triagram/awr2944p-dca1000-case/step/assembly.step

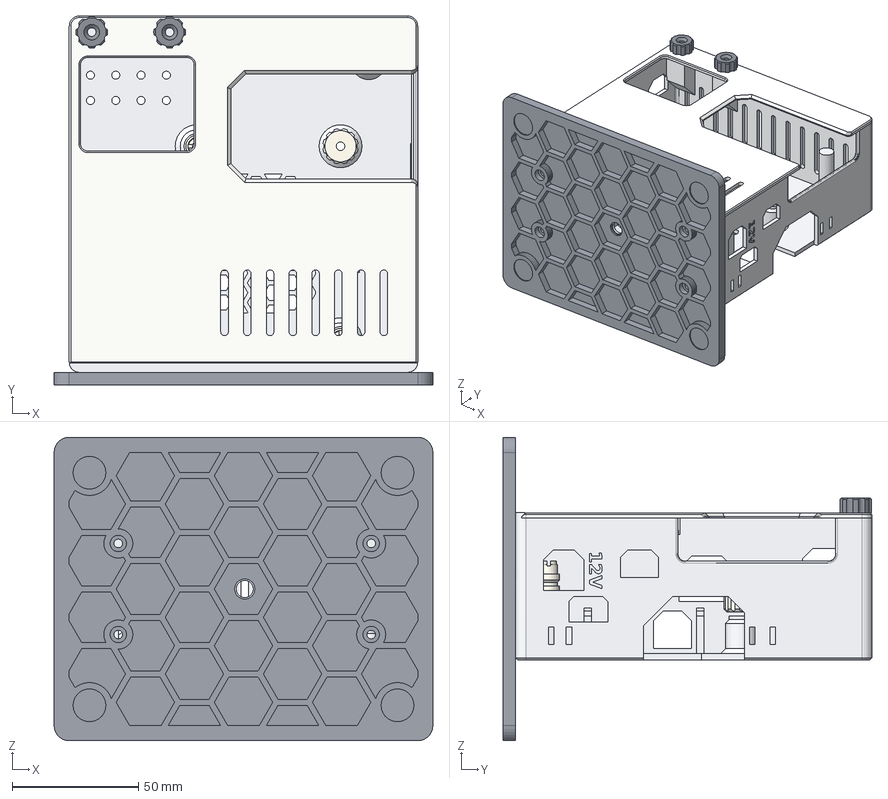
[picture p13: CAD file, 2026-11-10]
step/assembly.step
149.8 x 145.9 x 120.0 mm
case_body
front_guard
desk_foot
knob_1 x 2
spacer_1 x 3
thumb_nut
