triagram/awr2944p-dca1000-case/stl/body_pause_at_13.60mm_47.00mm_49.60mm.stl

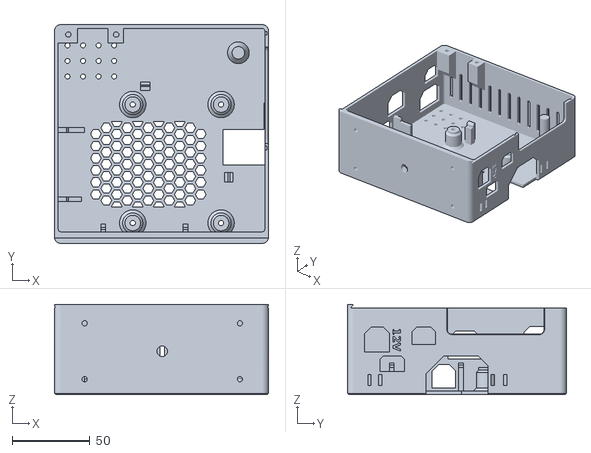
[picture p14: CAD file, 2026-11-10]
stl/body_pause_at_13.60mm_47.00mm_49.60mm.stl
137.8 x 140.9 x 58.2
