triagram/awr2944p-dca1000-case/stl/test_fit/awr2944pevm_dummy_front.stl

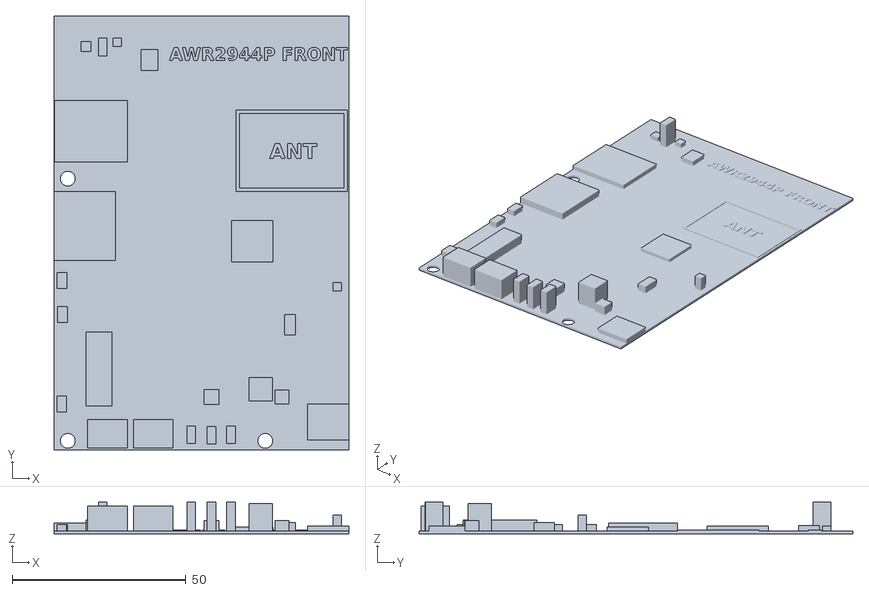
[picture p15: CAD file, 2026-11-01]
stl/test_fit/awr2944pevm_dummy_front.stl
85.0 x 125.0 x 9.18
