triagram/awr2944p-dca1000-case/stl/spacer_x3_pause_at_3.40mm_15.00mm.stl

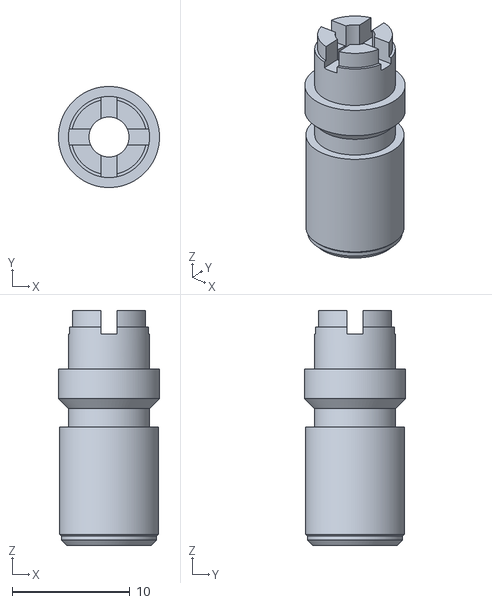
[picture p16: CAD file, 2026-11-10]
stl/spacer_x3_pause_at_3.40mm_15.00mm.stl
8.60 x 8.60 x 20.0
