triagram/awr2944p-dca1000-case/stl/test_fit/awr2944pevm_dummy_back.stl

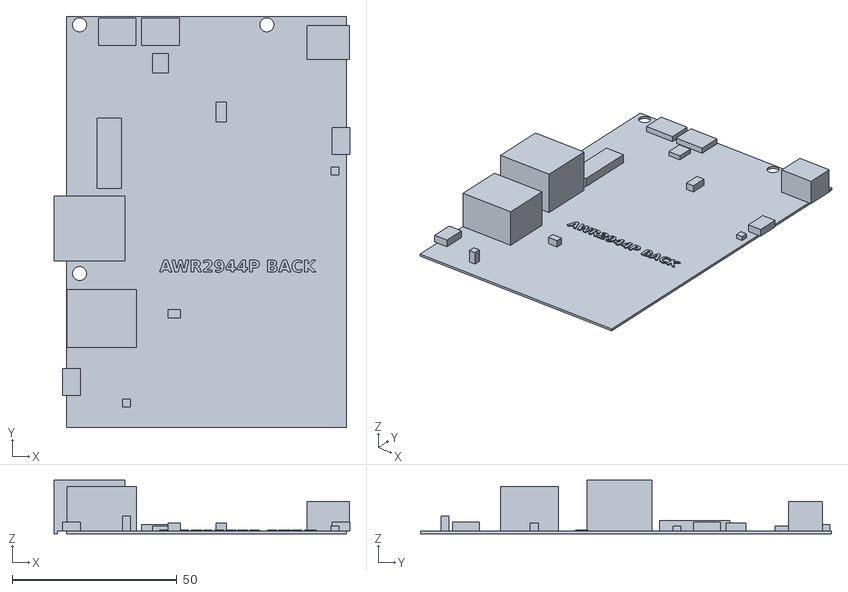
[picture p17: CAD file, 2026-11-01]
stl/test_fit/awr2944pevm_dummy_back.stl
89.9 x 125.0 x 16.3
