triagram/awr2944p-dca1000-case/stl/test_fit/dca1000_dummy_back.stl

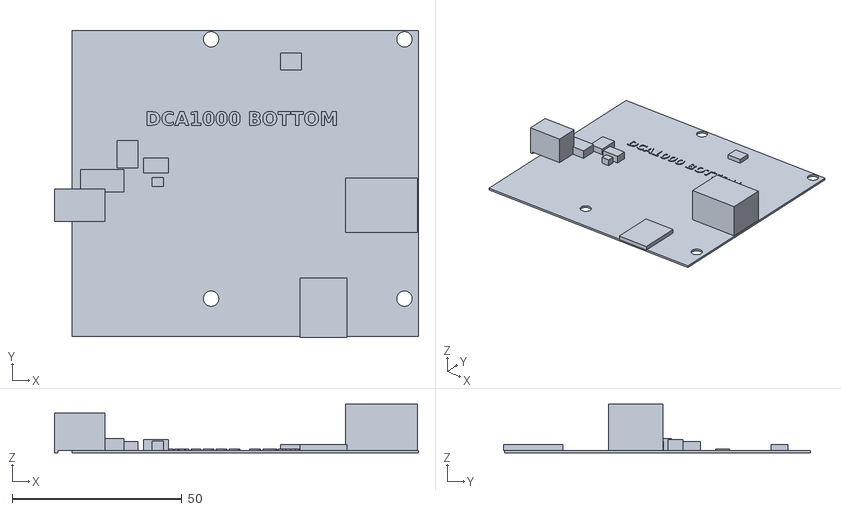
[picture p18: CAD file, 2026-11-01]
stl/test_fit/dca1000_dummy_back.stl
107.1 x 90.4 x 14.4
