triagram/awr2944p-dca1000-case/stl/knob_x2.stl

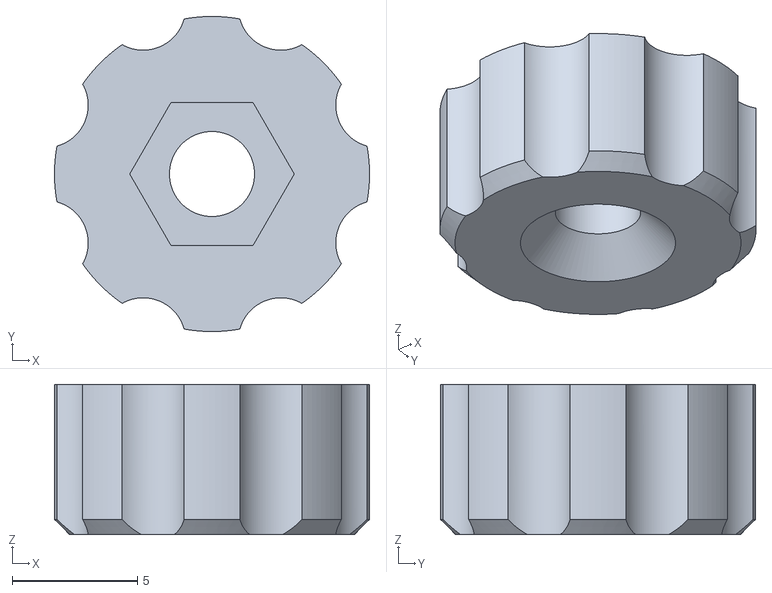
[picture p19: CAD file, 2026-11-01]
stl/knob_x2.stl
12.6 x 12.6 x 6.00
