triagram/awr2944p-dca1000-case/stl/test_fit/dca1000_dummy_front.stl

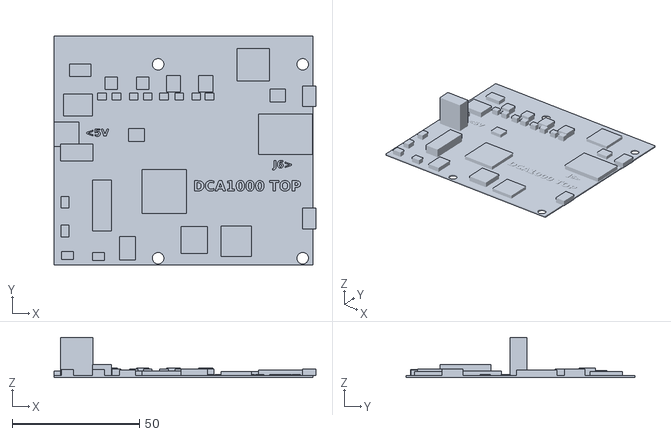
[picture p20: CAD file, 2026-11-01]
stl/test_fit/dca1000_dummy_front.stl
103.1 x 90.0 x 15.9
