triagram/awr2944p-dca1000-case/step/front_guard.step

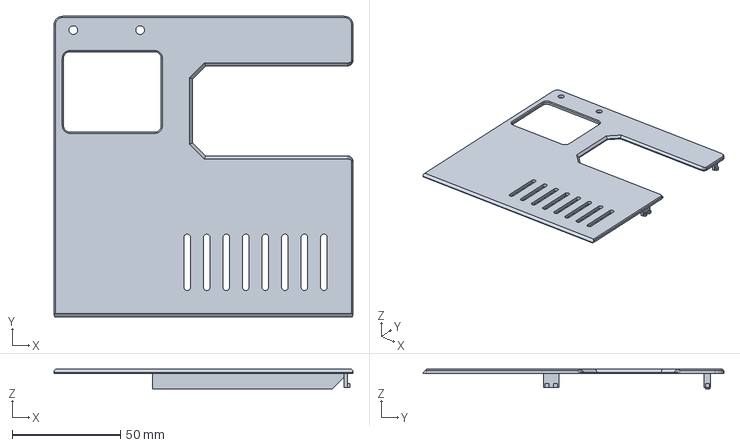
[picture p21: CAD file, 2026-11-01]
step/front_guard.step
137.8 x 138.5 x 9.00 mm
