triagram/awr2944p-dca1000-case/step/desk_foot.step

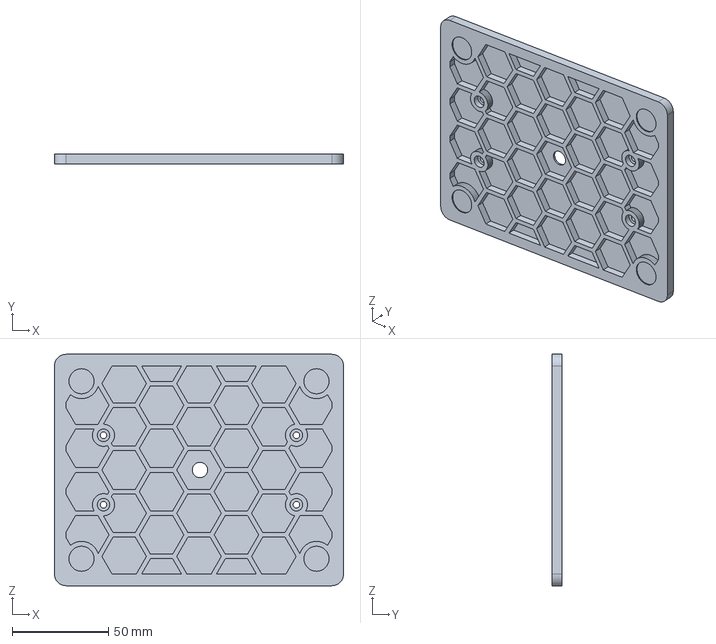
[picture p22: CAD file, 2026-11-01]
step/desk_foot.step
149.8 x 5.00 x 120.0 mm
