triagram/awr2944p-dca1000-case/step/thumb_nut.step

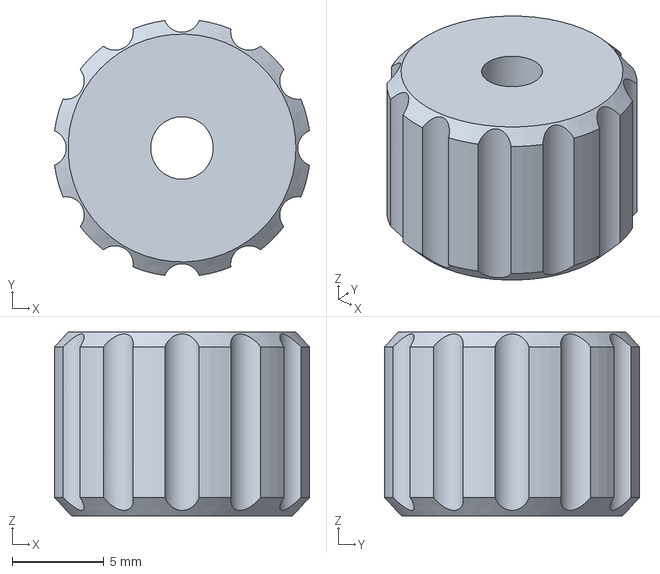
[picture p23: CAD file, 2026-11-10]
step/thumb_nut.step
13.9 x 13.9 x 10.0 mm
