triagram/awr2944p-dca1000-case/(list of files, cad)

Other CAD files:
step/spacer.step
step/body.step
step/knob.step
stl/thumb_nut_pause_at_3.40mm.stl
stl/desk_foot.stl
stl/front_guard.stl
