triagram/awr2944p-dca1000-case/images/print_pauses.zh-CN.png

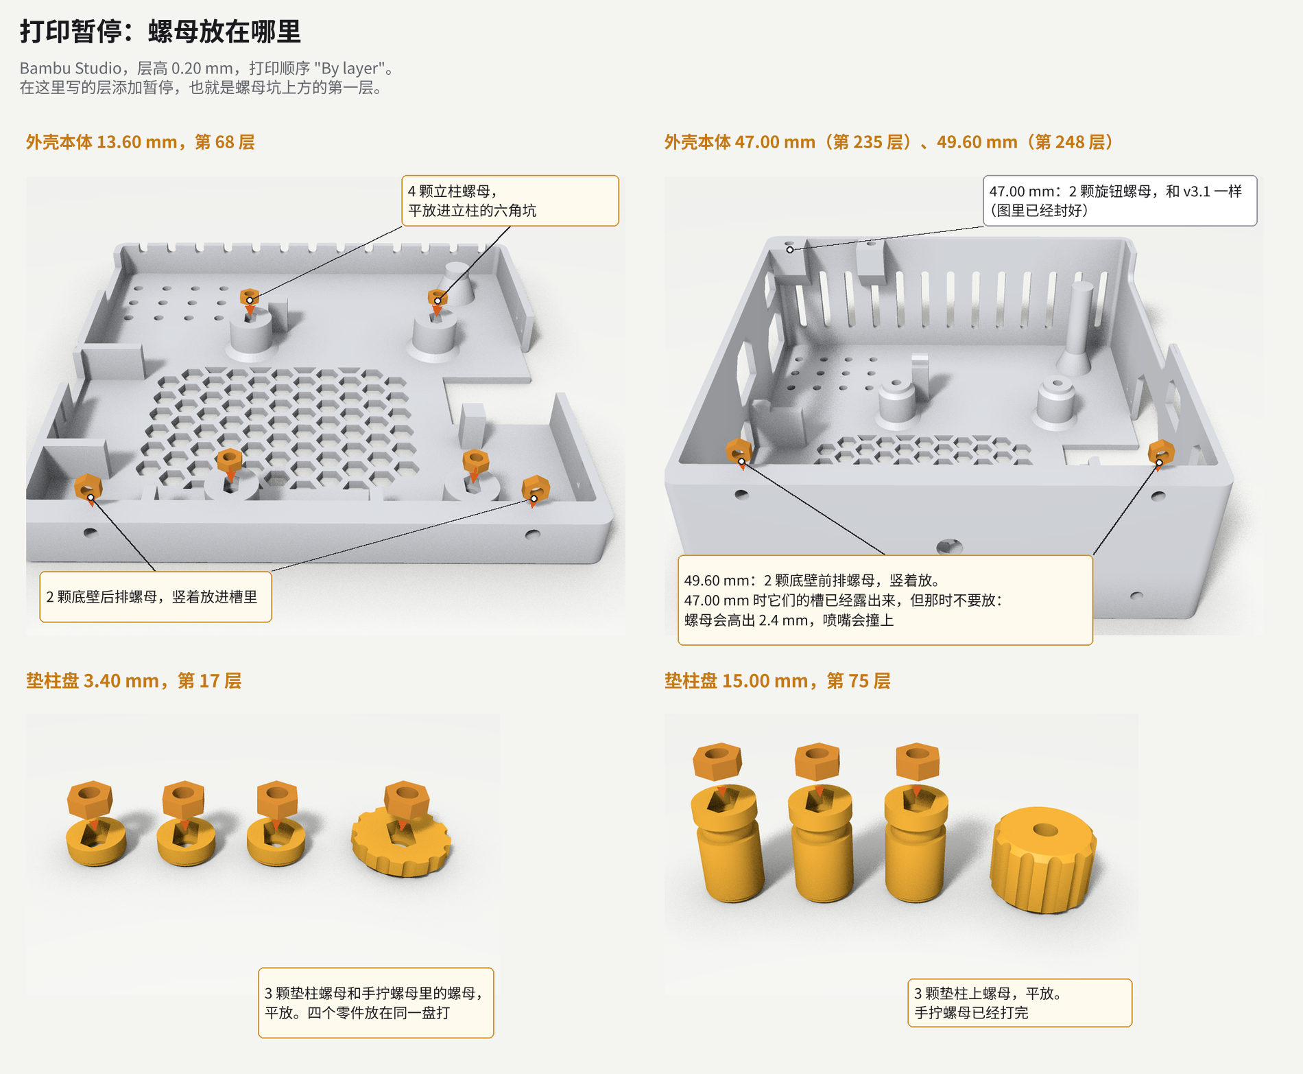
images/print_pauses.zh-CN.png
