triagram/awr2944p-dca1000-case/images/step0.zh-CN.png

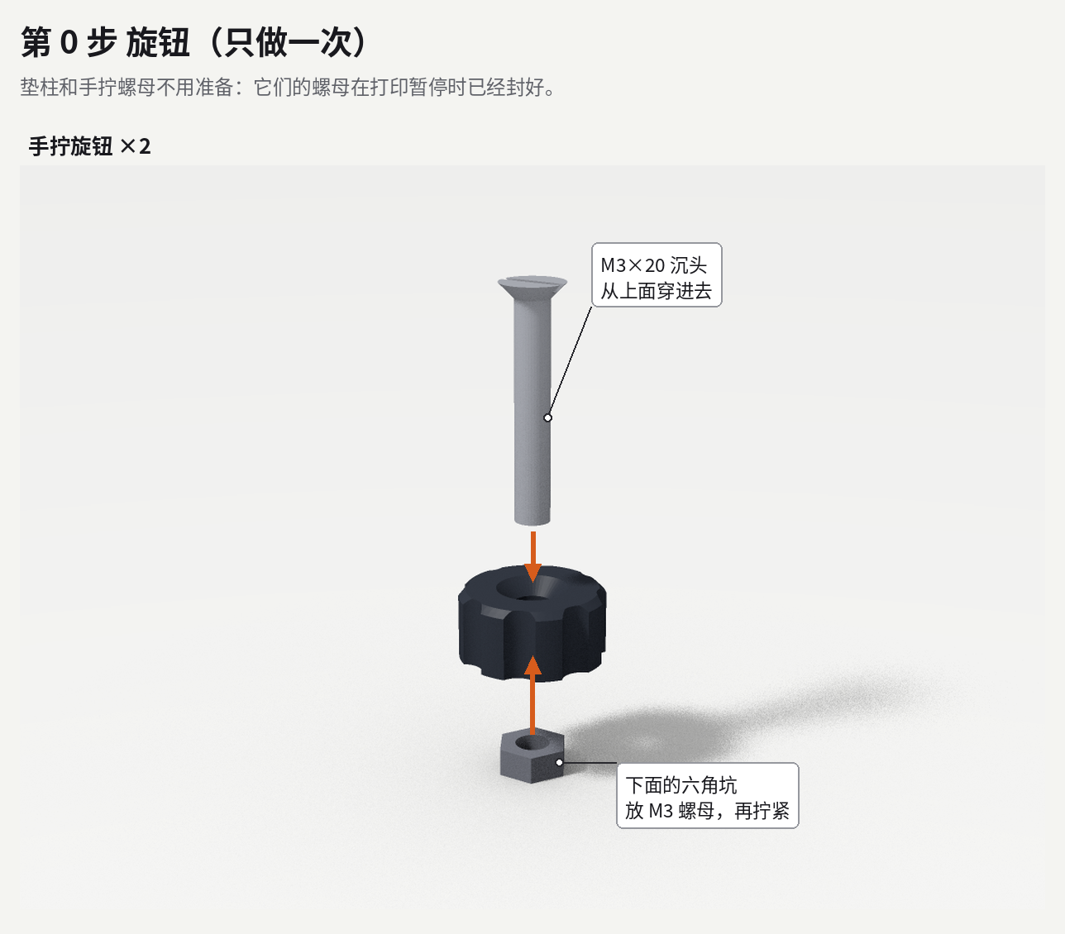
images/step0.zh-CN.png
