triagram/awr2944p-dca1000-case/images/step1.zh-CN.png

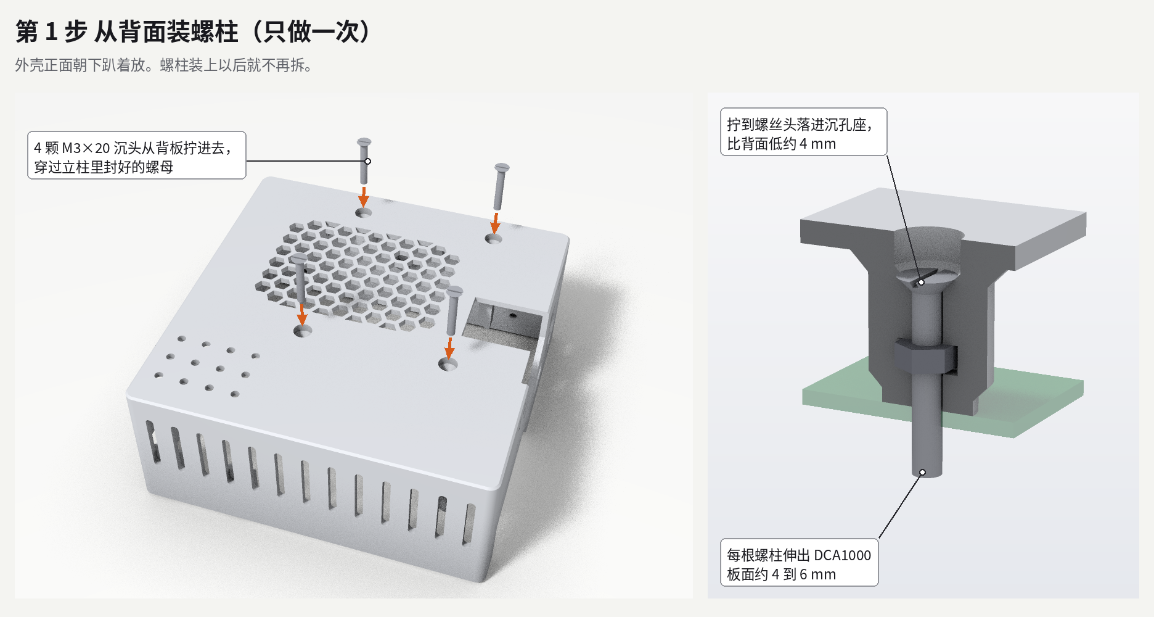
images/step1.zh-CN.png
