triagram/awr2944p-dca1000-case/images/step3.zh-CN.png

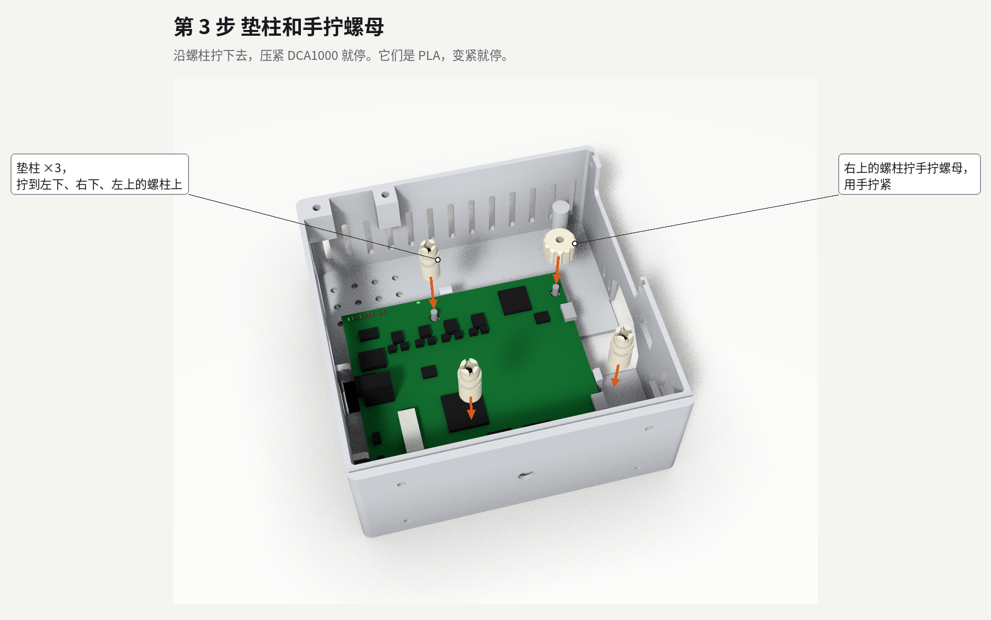
images/step3.zh-CN.png
