triagram/awr2944p-dca1000-case/images/step5.zh-CN.png

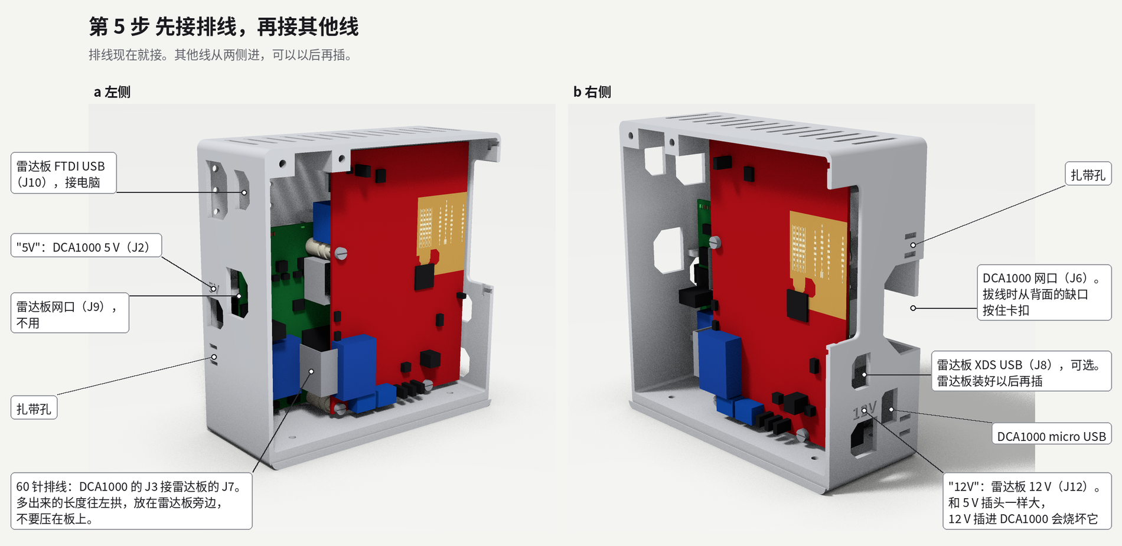
images/step5.zh-CN.png
