triagram/awr2944p-dca1000-case/images/step6.zh-CN.png

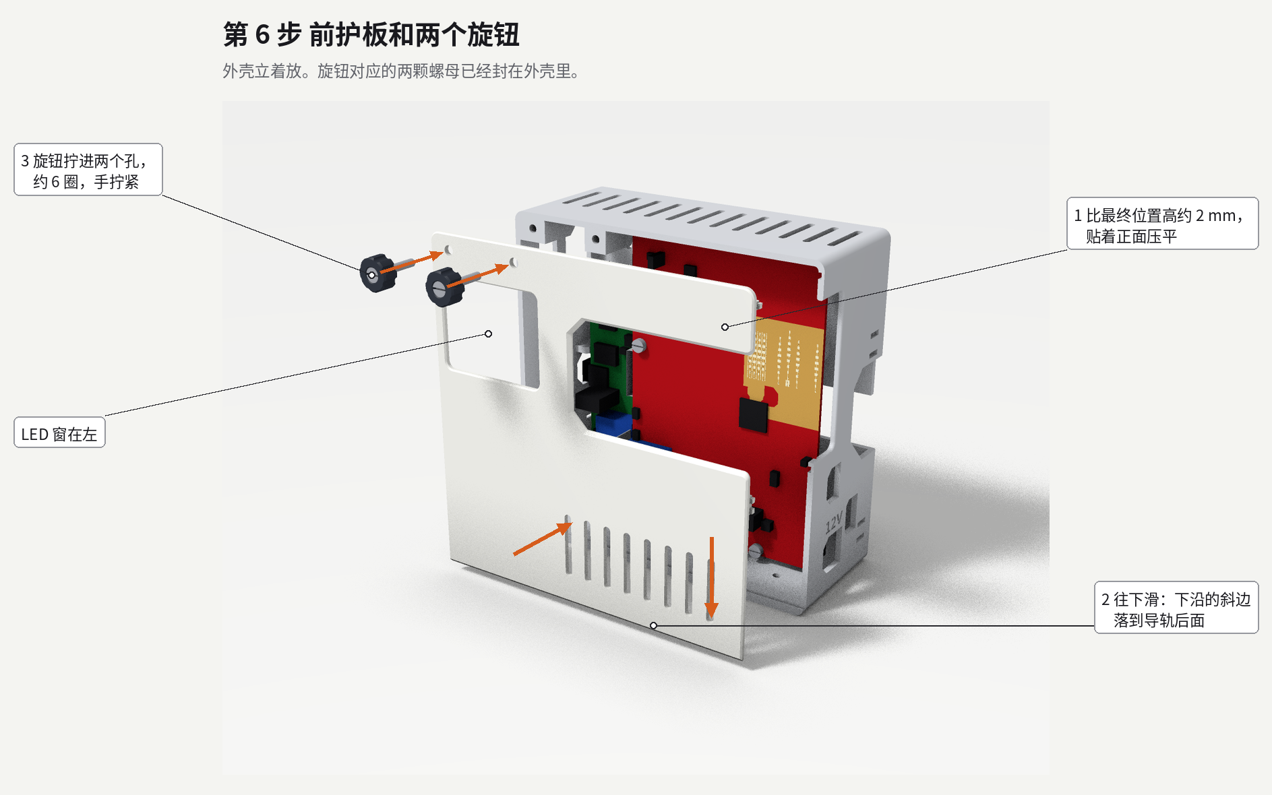
images/step6.zh-CN.png
