triagram/awr2944p-dca1000-case/design/v3.1-changes.zh-CN.md

# v3.1 为什么这样改

[English](v3.1-changes.md) | 简体中文

2026-10-23 定下的设计决定。外形尺寸、零件和装法都和 v3.0 一样。本体、前护板和桌面底座改了，旋钮和垫柱没变。TI 的 3 dB 和 6 dB 波束内没有新增遮挡和反射，和 v3.0 一样（见 [radar-assessment.zh-CN.md](radar-assessment.zh-CN.md)）。

## 1. J8 缺口旁的小墙加固

雷达板 J8 USB 缺口的上半段封起来改成窗口，竖直落下的内角加 R3 圆角。挂下滑扣的那块墙重新和整面墙连成一体：侧推 10 N 时层间应力从约 34 MPa 降到约 10 MPa，变形从 4.7 mm 降到 2.6 mm。

J8 插头（按 11 × 7.5 mm 外形检查）从 15 × 11 mm 的窗口插入，四周不碰；窗口顶和 J12 窗口顶对齐。雷达板和 DCA1000 从前面装进去的路径不碰。唯一的变化：J8 的 USB 线要在雷达板装好以后从侧面插。

**还有类似的地方吗？** 没有。本体和护板上所有薄的、单边连接的、会被滑扣或螺丝拉的地方都查了一遍，只有 J8 那一块是一端连着、另一端挂着滑扣；其他地方要么两端都连着，要么又短又粗，要么不受力。用同一个板壳模型算：上滑扣所在的那块墙连在顶墙的角上，侧推 10 N 只有 3 MPa、变形 0.08 mm；RJ45 开口上方那条墙两端都连着，最多约 10 MPa。

## 2. 尖角和倒角

1. 护板天线窗右侧开口处的两个尖角：R2.5。
2. 护板正面一圈和 LED 窗：0.6 mm 倒角；本体背面一圈：0.8 mm 倒角。贴床面只能倒角，顺便抵消第一层的“象脚”。
3. 右墙天线旁的降低段：上沿 R0.8，内角 R3。
4. 底部导轨唇口的尖边削出 0.4 mm 平台。

竖直落下的顶角不倒圆：它在护板下面摸不到，倒圆反而会多出一小块把斜射信号往前反射的斜面。

## 3. 底部导轨补到两个角

导轨唇口延伸到两个角，按外壳的 R4 外轮廓切齐，护板下角改成和外壳同一条轮廓。装法不变：装护板的整个过程（45 个位置）逐一检查过，不会碰到；装好后往外拉 0.25 到 0.4 mm 就被卡住，和以前一样。唇口压住护板下边的长度从 129 mm 变成全宽 137.8 mm，更稳。

## 4. 减重

背板蜂窝格栅不影响结构强度，主要是外观和通风，只轻 2 g。底座不挖穿的话，小格蜂窝反而更重；要用 20 mm 的大格、留 1 mm 顶皮，才能轻约 5 g。

**背板格栅。** 用背板的板壳模型比较 v3.0 的长孔和蜂窝格栅（6 mm 格、1.8 mm 筋）。背板贴床平着打，弯曲应力沿着层走，Bambu PLA Basic 层内弯曲强度 76 MPa。

| 受力 | 长孔（v3.0） | 蜂窝格栅（v3.1） |
| --- | --- | --- |
| 板子压在 4 根立柱上，20 N | 0.16 mm，5 MPa | 0.20 mm，5 MPa |
| 手指在格栅中间按 2 kg，20 N | 0.55 mm，10 MPa | 0.92 mm，17 MPa |

正常受力几乎没有区别；手按中间会软一点，应力还不到强度的四分之一。格栅的通风面积是长孔的两倍。

**桌面底座。** 打印出来的实心板里面本来就是 15% 的稀疏填充，重量在上下两层实心皮和外圈墙。不挖穿的小孔会多出很多孔壁和孔底的实心层，所以 10 mm 小格、挖一半深反而重 3 g；格子大、挖得深才划算。

| 底座方案 | 估算重量 | 变化 |
| --- | --- | --- |
| 实心（v3.0） | 49.4 g | |
| 10 mm 小格蜂窝，挖一半深（2.5 mm） | 52.6 g | +3.2 g |
| 10 mm 小格蜂窝，留 0.8 mm 顶皮 | 49.8 g | +0.4 g |
| 20 mm 大格蜂窝，留 1 mm 顶皮（采用） | 44.4 g | −5.0 g |
| 4 个大盲槽，留 1 mm 顶皮 | 43.5 g | −5.9 g |
| 4 个通窗（未采用） | 35.8 g | −13.6 g |

20 mm 大格蜂窝开在底面（打印时朝上，不用支撑），上表面和以前一模一样；螺丝孔、三脚架孔和橡胶脚垫的位置留实心。底座只放在桌上，1 mm 顶皮加 2.4 mm 的筋足够。

**顶部散热槽**延伸到右边（−1 g），不影响强度。

重量按切片方式估算（0.2 mm 层高、3 圈墙、15% 填充），Bambu Studio 显示的数可能差 10% 左右。

## 5. 保留打印暂停

保留封闭螺母坑：暂停加在 47.00 mm（第 235 层），旋钮的螺母永远掉不出来。为防忘记，本体的文件名里写上了暂停高度。另一个办法是把螺母坑改成侧面插入的槽，不用暂停，但拧下旋钮时螺母可能掉出来。

## 6. 前护板上放 logo 的位置

当时给自用做过一版带大学 logo 的护板，没有公开（logo 不是我们能授权的）。这里记下选定的位置，以后要加 logo 或标签，不用再重新选。v3.2 的护板没变，所以仍然适用。

**选定的位置。** 护板左侧的实心区域，在进风槽的高度以上、LED 窗以下。从正面看，以护板左下角为原点：60 × 18.6 mm 的区域，x 从 7.9 到 67.9 mm，y 从 46.1 到 64.7 mm。四周约留 7.3 mm 空白（学校品牌规范对 60 mm 宽 logo 要求的 1U 边距），离天线窗很远。

**还看过的位置**，都在护板实心面上，离最近的边或开口至少 4.9 mm：

| 位置 | 最大尺寸 | 留白 |
| --- | --- | --- |
| 顶部横梁，旋钮右边空白的正中 | 38 × 11.8 mm | 上下约 1U |
| 顶部横梁，靠右，离右边 1U | 38 × 11.8 mm | 上下约 1U |
| 进风槽上方正中 | 72 × 22.3 mm | 上下只有约 0.7U |

**做法。** 外表面嵌 0.6 mm 厚的 logo：就是层高 0.20 mm 时的前 3 层，用 AMS 换第二种耗材；护板照常外面朝下打印。在切片软件里从上往下看，logo 是反的。浅色护板配深色 logo；深色护板配白色 logo 要约 0.8 mm 厚才盖得住，而且按品牌规范要加彩色底框。0.4 mm 喷嘴会丢掉比一条线还细的笔画（60 mm 宽的 logo 约丢 7%）；单独用 0.2 mm 喷嘴打护板，细节保留得更多。和普通护板一样，不要用含金属粉或碳纤维的耗材。

## 来源

- 暂停的时机：[Setting pause in Bambu Studio](https://forum.bambulab.com/t/setting-pause-in-bambu-studio/154801)、[Pause at layer?](https://forum.bambulab.com/t/pause-at-layer/7025)、[Pausing a print to add inserts](https://forum.bambulab.com/t/pausing-a-print-to-add-inserts/158040)。
- PLA 强度：[Bambu PLA Basic Technical Data Sheet V2.0](https://www.additive-x.com/shop/mpattachments/file/viewonline/id/494/product_id/2236)。
- 天线检查：[radar-assessment.zh-CN.md](radar-assessment.zh-CN.md)。
