triagram/awr2944p-dca1000-case/(commit log)

2026-11-01 v2.0: front guard that stays on while measuring
    Changes after the test fit of v1.0:
    - Front guard instead of the transport lid: antenna window open to the
    right, LED window over the DCA1000 status LEDs, two hand knobs at the top
    left, lower edge held by a rail on the case.
    - Spacers hold two M3 nuts each instead of the screws cutting their own
    thread. They are round, so they clear the radar board's Ethernet jack in
    any rotation. Printed collars go under the front screws; every board
    screw is an M3x20 countersunk.
    - Back posts 10 mm thick with countersunk seats; ledges locate the DCA1000
    and ribs support it on the DIP switch side.
    - The top edge of the right Ethernet cut-out is o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
    [body.step, body.stl, collar_x3.stl, front_guard.stl, knob_x2.stl, spacer_x3.stl, transport_lid.stl]
2026-11-01 v1.0: first version
    Case body, desk foot, transport lid, printed hex spacers that the screws
    thread into, and two-piece dummy boards for a test fit. STEP model of the
    case body.
    [awr2944pevm_dummy_back.stl, awr2944pevm_dummy_front.stl, body.step, body.stl, dca1000_dummy_back.stl, dca1000_dummy_front.stl, desk_foot.stl, spacer_x3.stl]
2026-11-01 v3.1: stiffer, lighter, smoother
    - The J8 notch is closed at the top into a window, and the wall piece that
    carries the lower clip is joined to the rest of the wall. The J8 USB
    cable now plugs in after the radar board.
    - Fillets and chamfers on sharp corners and edges; the rail lip ends in a
    0.4 mm flat.
    - The bottom rail runs into both corners; the lower corners of the guard
    follow the case outline.
    - Honeycomb grid in the back instead of slots, top vent slots extended to
    the right, honeycomb pockets under the desk foot.
    - STEP models of every part and of the assembly.
    - Knob, spacer and dummy boards unchanged.
    Reasons and numbers: design/v3.1-changes.md.
    [assembly.step, body.step, body_pause_at_47.00mm.stl, desk_foot.step, desk_foot.stl, front_guard.step, front_guard.stl, knob.step]
2026-11-01 v3.0: clips on the right edge of the front guard
    - Two clips on the right edge of the guard hook into slots inside the
    right wall (0.3 mm clearance), so the guard is held on the right too.
    - Right wall at full height below y 53.7 mm (below 20 mm before), ending
    in a vertical drop that keeps the antenna beam clear; see
    design/radar-assessment.md.
    - Knob, spacer, desk foot and dummy boards unchanged.
    [body_pause_at_47.00mm.stl, front_guard.stl]
2026-11-01 v2.1: knob nuts sealed in during the print
    - The two knob nuts are sealed into the bosses with a print pause at
    47.00 mm, so they no longer fall out when the knobs come off. The body
    file name carries the pause height.
    - Top wall back to full height and right wall full height above 116 mm:
    the guard rests on the case along its top edge and right end.
    - New spacer, flat end on the DCA1000; no collars. Radar board and desk
    foot screws are M3x12 pan head.
    - Radar dummy follows the real AWR2944PEVM.
    - Front guard, knob and desk foot unchanged.
    [awr2944pevm_dummy_back.stl, awr2944pevm_dummy_front.stl, body.stl, body_pause_at_47.00mm.stl, collar_x3.stl, spacer_x3.stl]
2026-11-10 v3.2: every screw from the front
    - The four back M3x20 countersunk screws become studs: put in once
    through a nut sealed in each post, heads about 4 mm deep. The
    DCA1000 drops onto them.
    - Round spacers with both nuts sealed in at print pauses, turned onto
    the studs with a screwdriver in a cross slot; no side slots.
    - A printed thumb nut on the fourth DCA1000 hole instead of a nut held
    with pliers.
    - Desk-foot nuts sealed in the floor, so the foot goes on last.
    - "5V" and "12V" engraved next to the two power jacks.
    - Body pauses at 13.60, 47.00 and 49.60 mm; spacer plate pauses at
    3.40 and 15.00 mm.
    - Front guard, knobs, desk foot and dummy boards unchanged; the new body
    still ta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
    [assembly.step, body.step, body_pause_at_13.60mm_47.00mm_49.60mm.stl, body_pause_at_47.00mm.stl, spacer.step, spacer_x3.stl, spacer_x3_pause_at_3.40mm_15.00mm.stl, thumb_nut.step]
